osmocom/osmo-e1-hardware/hardware/e1-xcvr/e1_xcvr.brd

## EAGLE design hardware/e1-xcvr/e1_xcvr.brd (2020-11-04)

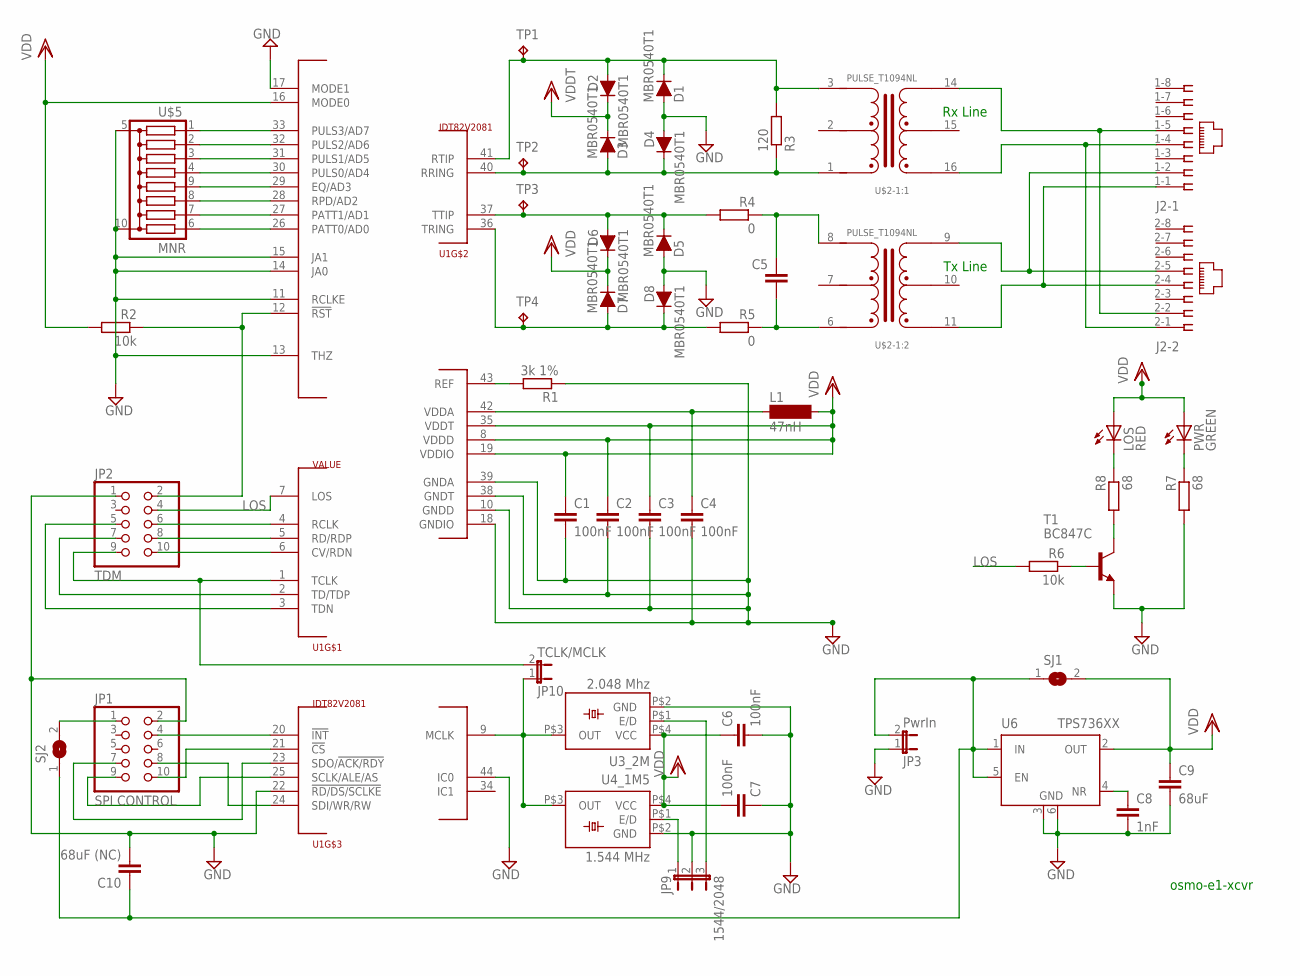
[picture p4: schematic e1_xcvr.sch]

Parts:
C1, C2, C3, C4, C6, C7: 100nF; C0603
C5: C-EUC0603; C0603
C8: 1nF; C0603
C9: 68uF; C1206K
C10: 68uF (NC); C1206K
D1, D2, D3, D4, D5, D6, D7, D8: MBR0540T1; SOD123
J2: 557560-1
JP1: SPI CONTROL; 2X05
JP2: TDM; 2X05
JP3: PwrIn; JP1
JP9: 1544/2048; JP2
JP10: TCLK/MCLK; JP1
L1: 47nH; SM-1206
LOS: RED; CHIPLED_0805
PWR: GREEN; CHIPLED_0805
R1: 3k 1%; R0603
R2, R6: 10k; R0603
R3: 120; R0603
R4, R5: 0; R0603
R7, R8: 68; R0603
SJ1, SJ2: SJ
T1: BC847C; SOT23-BEC
TP1, TP2, TP3, TP4: TPPAD1-13; P1-13
U1: IDT82V2081; TQFP44
U3_2M: 2.048 Mhz; HC73
U4_1M5: 1.544 MHz; HC73
U6: TPS736XX; SOT223-6
U$2: PULSE_T1094NL; PULSE_BH
U$5: MNR; MNR35

Connections:
!CS: JP1.10, U1.21 (!CS)
!INT: JP1.4, U1.20 (!INT)
!RST: JP2.2, R2.1, U1.12 (!RST)
GND: C1.2, C2.2, C3.2, C4.2, C6.2, C7.1, C8.2, C9.2, C10.2, D1.2 (A), D4.2 (A), D5.2 (A), D8.2 (A), JP1.2, JP2.1, JP3.1, JP9.2, R1.1, R7.2, T1.E, U1.10 (GNDD), U1.11 (RCLKE), U1.13 (THZ), U1.14 (JA0), U1.15 (JA1), U1.17 (MODE1), U1.18 (GNDIO), U1.22 (!RD/DS/SCLKE), U1.38 (GNDT), U1.39 (GNDA), U1.44 (IC0), U3_2M.P$2 (GND), U4_1M5.P$2 (GND), U6.3 (GND), U6.6 (GND1), U$5.5 (C), U$5.10 (D)
LOS: JP2.4, R6.2, U1.7 (LOS)
MCLK: JP10.1, U1.9 (MCLK), U3_2M.P$3 (OUT), U4_1M5.P$3 (OUT)
unnamed: R1.2, U1.43 (REF)
unnamed: LOS.C, R8.1
unnamed: U1.33 (PULS3/AD7), U$5.1
unnamed: U1.32 (PULS2/AD6), U$5.2
unnamed: U1.31 (PULS1/AD5), U$5.3
unnamed: U1.30 (PULS0/AD4), U$5.4
unnamed: U1.29 (EQ/AD3), U$5.9 (5)
unnamed: U1.28 (RPD/AD2), U$5.8 (6)
unnamed: U1.27 (PATT1/AD1), U$5.7
unnamed: U1.26 (PATT0/AD0), U$5.6 (8)
unnamed: R8.2, T1.C
unnamed: C4.1, L1.1, U1.42 (VDDA)
unnamed: R6.1, T1.B
unnamed: C5.1, R4.1, U$2.8
unnamed: PWR.C, R7.1
unnamed: C5.2, R5.1, U$2.6
unnamed: J2.1-2 (2), J2.2-5 (5), U$2.9
unnamed: J2.1-4 (4), J2.2-1 (1), U$2.16
unnamed: JP9.3, U3_2M.P$1 (E/D)
unnamed: J2.1-1 (1), J2.2-4 (4), U$2.11
unnamed: C8.1, U6.4 (NR)
unnamed: JP9.1, U4_1M5.P$1 (E/D)
unnamed: J2.1-5 (5), J2.2-2 (2), U$2.14
RCLK: JP2.6, U1.4 (RCLK)
RDN: JP2.10, U1.6 (CV/RDN)
RDP: JP2.8, U1.5 (RD/RDP)
RRING: D3.2 (A), D4.1 (C), R3.1, TP2.TP, U1.40 (RRING), U$2.1
RTIP: D1.1 (C), D2.2 (A), R3.2, TP1.TP, U1.41 (RTIP), U$2.3
SCLK: JP1.9, U1.25 (SCLK/ALE/AS)
SDI: JP1.8, U1.24 (SDI/WR/RW)
SDO: JP1.7, U1.23 (SDO/!ACK/RDY)
TCLK: JP2.9, JP10.2, U1.1 (TCLK)
TDN: JP2.5, U1.3 (TDN)
TDP: JP2.7, U1.2 (TD/TDP)
TRING: D7.2 (A), D8.1 (C), R5.2, TP4.TP, U1.36 (TRING)
TTIP: D5.1 (C), D6.2 (A), R4.2, TP3.TP, U1.37 (TTIP)
VDD: C1.1, C2.1, C3.1, C6.1, C7.2, C9.1, D2.1 (C), D3.1 (C), D6.1 (C), D7.1 (C), L1.2, LOS.A, PWR.A, R2.2, SJ1.2, U1.8 (VDDD), U1.16 (MODE0), U1.19 (VDDIO), U1.35 (VDDT), U3_2M.P$4 (VCC), U4_1M5.P$4 (VCC), U6.2 (OUT)
VIN: C10.1, JP3.2, SJ1.1, SJ2.1, U6.1 (IN), U6.5 (EN)
_VIN: JP1.1, SJ2.2

Notes on the sheet:
Rx Line
Tx Line
osmo-e1-xcvr

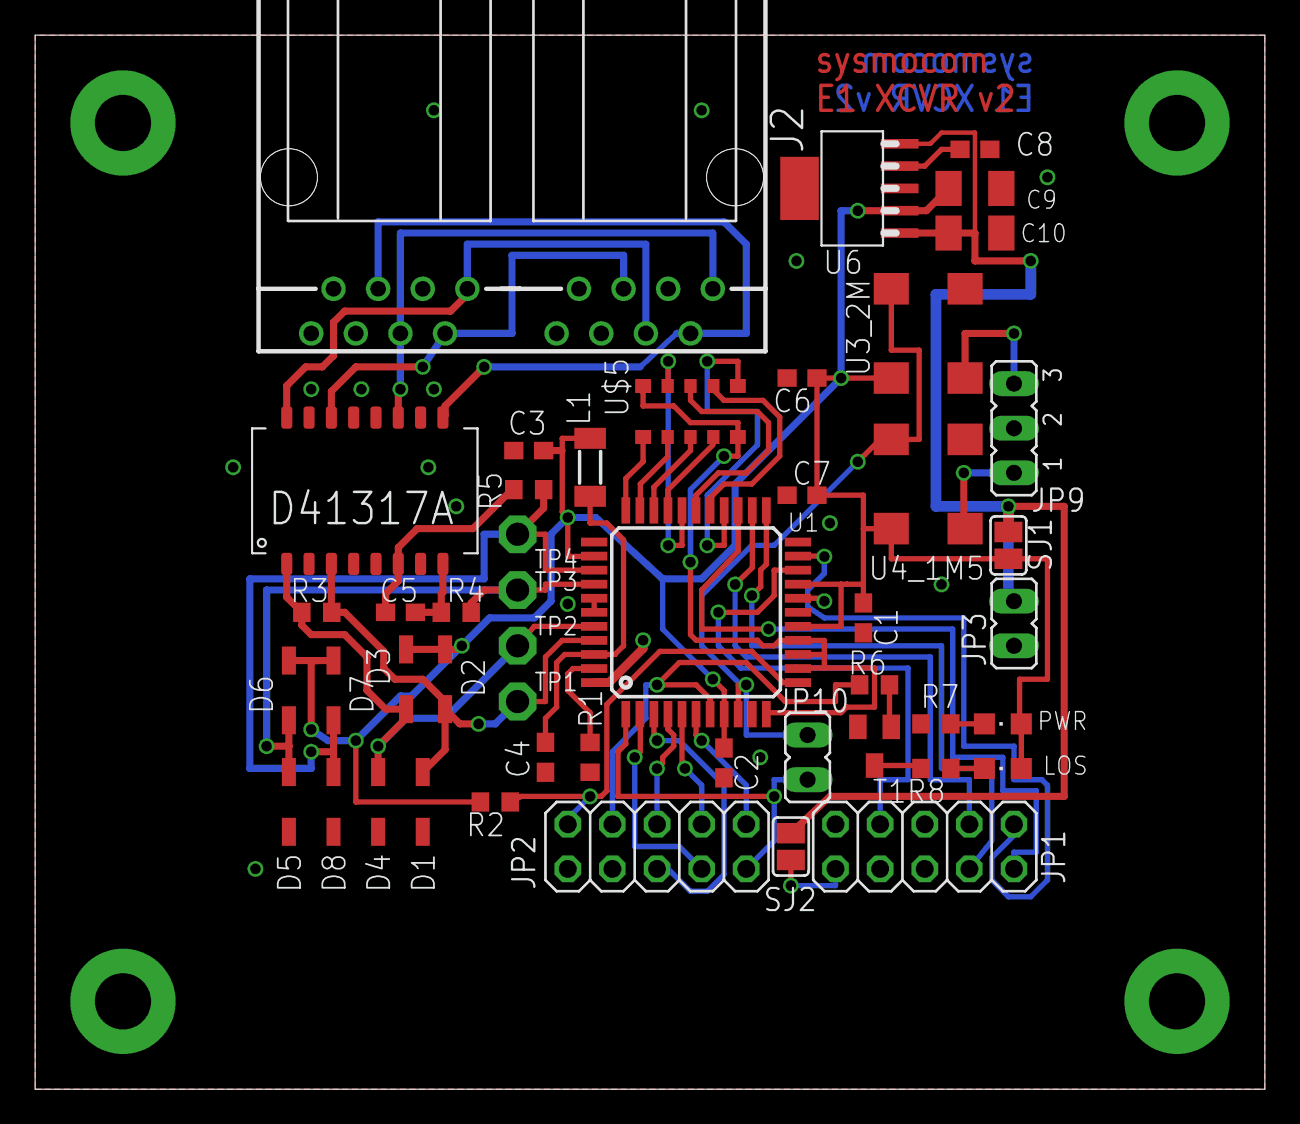
[picture p5: board e1_xcvr.brd from above]

Board: 2 copper layers, 70.0 x 60.0 mm, 48 parts (0 on the bottom side), 45 nets.
