osmocom/osmo-e1-hardware/hardware/icE1usb-proto/icE1usb-proto.brd

## EAGLE design hardware/icE1usb-proto/icE1usb-proto.brd (2020-09-14)

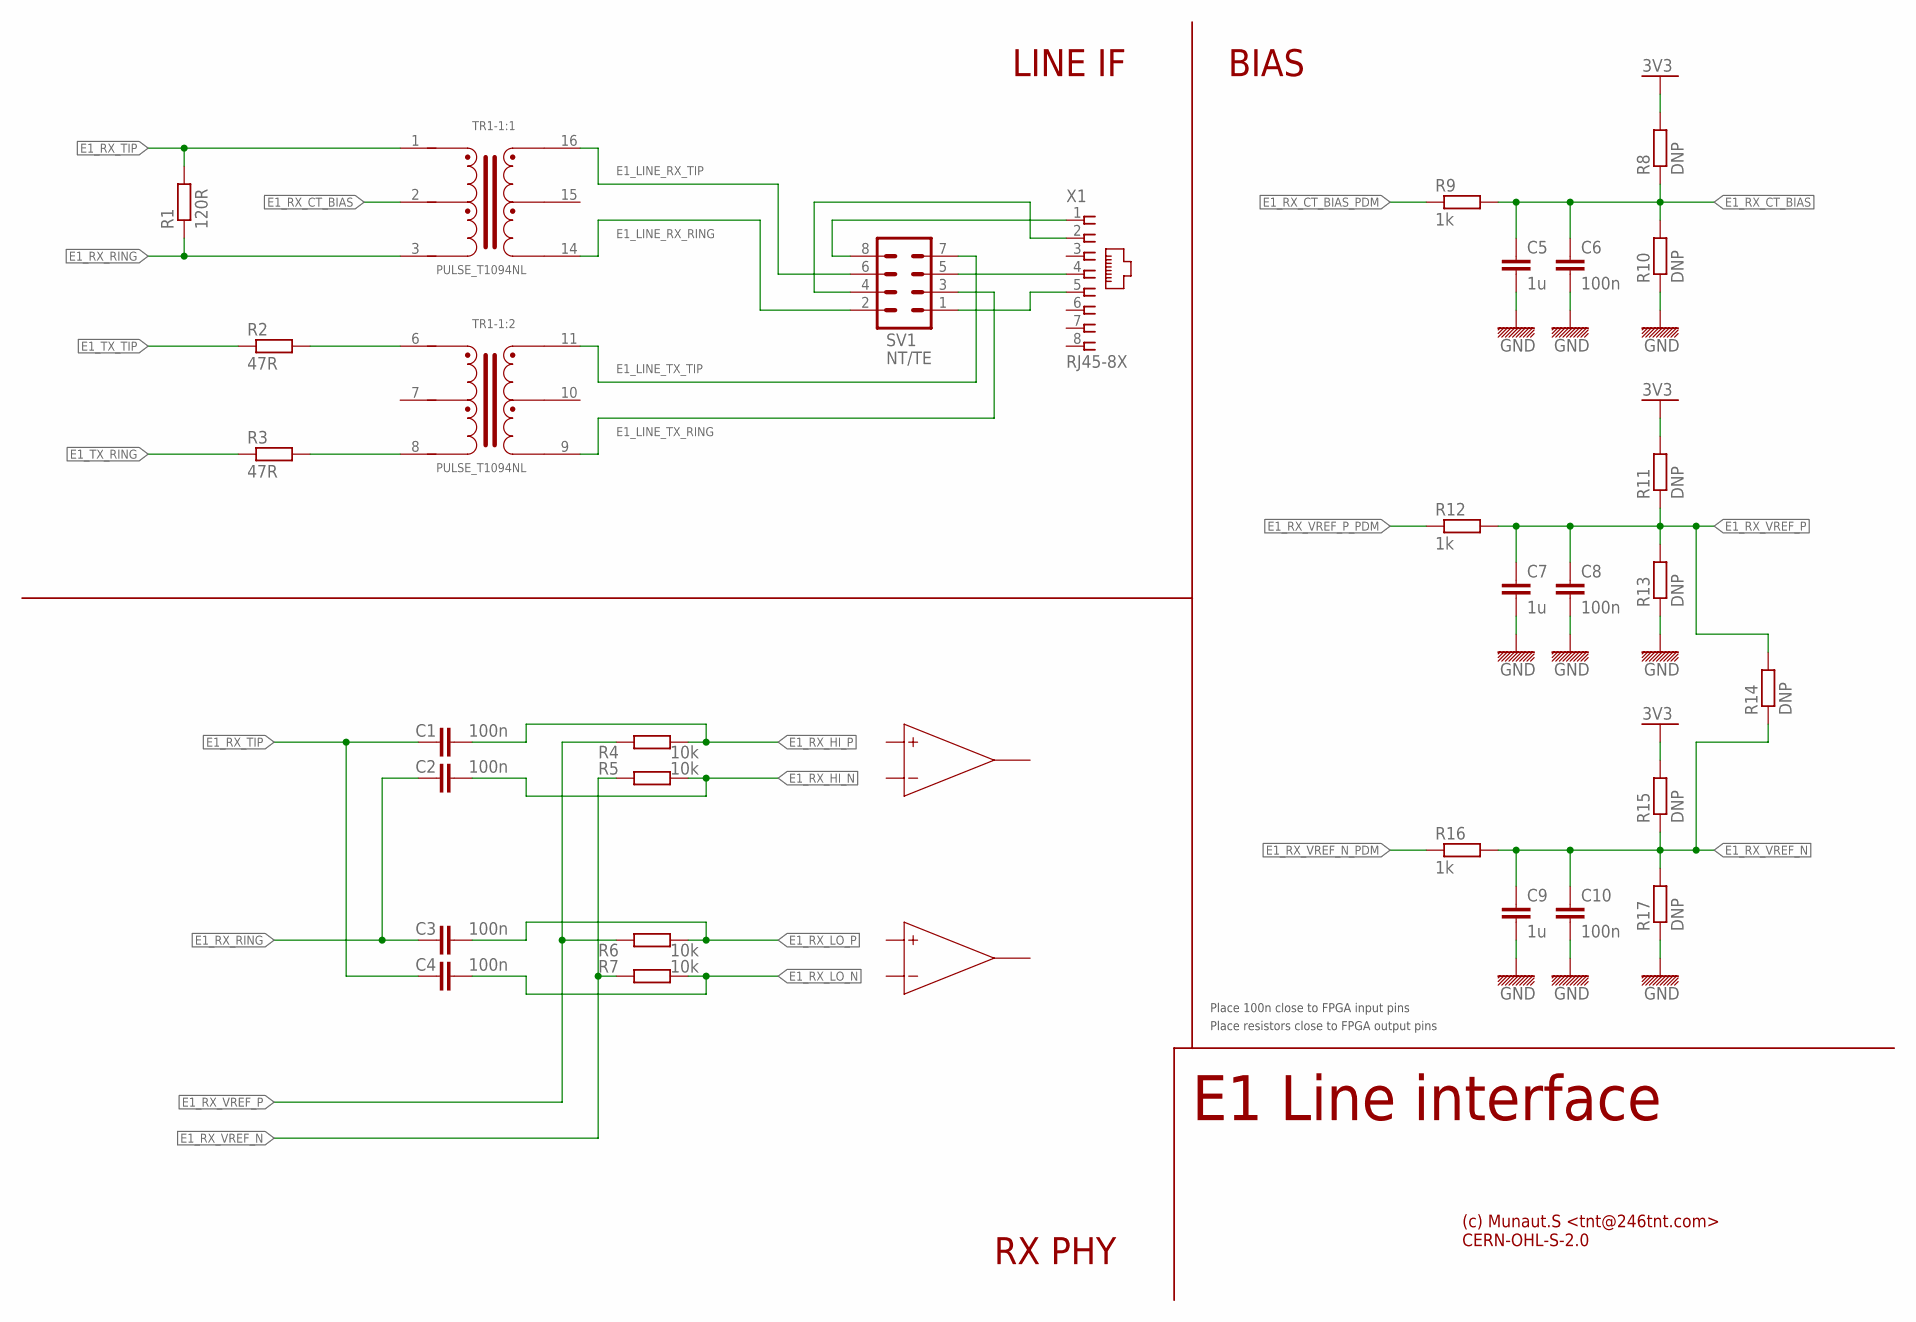
[picture p6: schematic icE1usb-proto.sch, sheet 1, <b>E1 Line interface</b>]

Parts:
C1, C2, C3, C4, C6, C8, C10: 100n; 0603
C5, C7, C9: 1u; 0603
R1: 120R; 0603_A
R2, R3: 47R; 0603_A
R4, R5, R6, R7: 10k; 0603_A
R8, R10, R11, R13, R14, R15, R17: DNP; 0603_A
R9, R12, R16: 1k; 0603_A
SV1: NT/TE; MA04-2
TR1: PULSE_T1094NL; PULSE_BH
X1: RJ45-8X; RJ45-NO-SHIELD

Connections:
3V3: R8.2, R11.2, R15.2; also elsewhere on the board
E1_LINE_P1: SV1.8, X1.1
E1_LINE_P2: SV1.4, X1.2
E1_LINE_P4: SV1.5, X1.4
E1_LINE_P5: SV1.1, X1.5
E1_LINE_RX_RING: SV1.2, TR1.14
E1_LINE_RX_TIP: SV1.6, TR1.16
E1_LINE_TX_RING: SV1.3, TR1.9
E1_LINE_TX_TIP: SV1.7, TR1.11
E1_RX_CT_BIAS: C5.1, C6.1, R8.1, R9.2, R10.2, TR1.2
E1_RX_CT_BIAS_PDM: R9.1; also elsewhere on the board
E1_RX_HI_N: C2.2, R5.2; also elsewhere on the board
E1_RX_HI_P: C1.2, R4.2; also elsewhere on the board
E1_RX_LO_N: C4.2, R7.2; also elsewhere on the board
E1_RX_LO_P: C3.2, R6.2; also elsewhere on the board
E1_RX_RING: C2.1, C3.1, R1.1, TR1.3
E1_RX_TIP: C1.1, C4.1, R1.2, TR1.1
E1_RX_VREF_N: C9.1, C10.1, R5.1, R7.1, R14.1, R15.1, R16.2, R17.2
E1_RX_VREF_N_PDM: R16.1; also elsewhere on the board
E1_RX_VREF_P: C7.1, C8.1, R4.1, R6.1, R11.1, R12.2, R13.2, R14.2
E1_RX_VREF_P_PDM: R12.1; also elsewhere on the board
E1_TX_RING: R3.1; also elsewhere on the board
E1_TX_TIP: R2.1; also elsewhere on the board
GND: C5.2, C6.2, C7.2, C8.2, C9.2, C10.2, R10.1, R13.1, R17.1; also elsewhere on the board
unnamed: R2.2, TR1.6
unnamed: R3.2, TR1.8

Notes on the sheet:
BIAS
LINE IF
RX PHY
E1 Line interface
Place 100n close to FPGA input pins
Place resistors close to FPGA output pins
(c) Munaut.S <tnt@246tnt.com> CERN-OHL-S-2.0
