osmocom/osmo-e1-hardware/hardware/icE1usb-proto/icE1usb-proto.brd

## EAGLE design hardware/icE1usb-proto/icE1usb-proto.brd (continued)

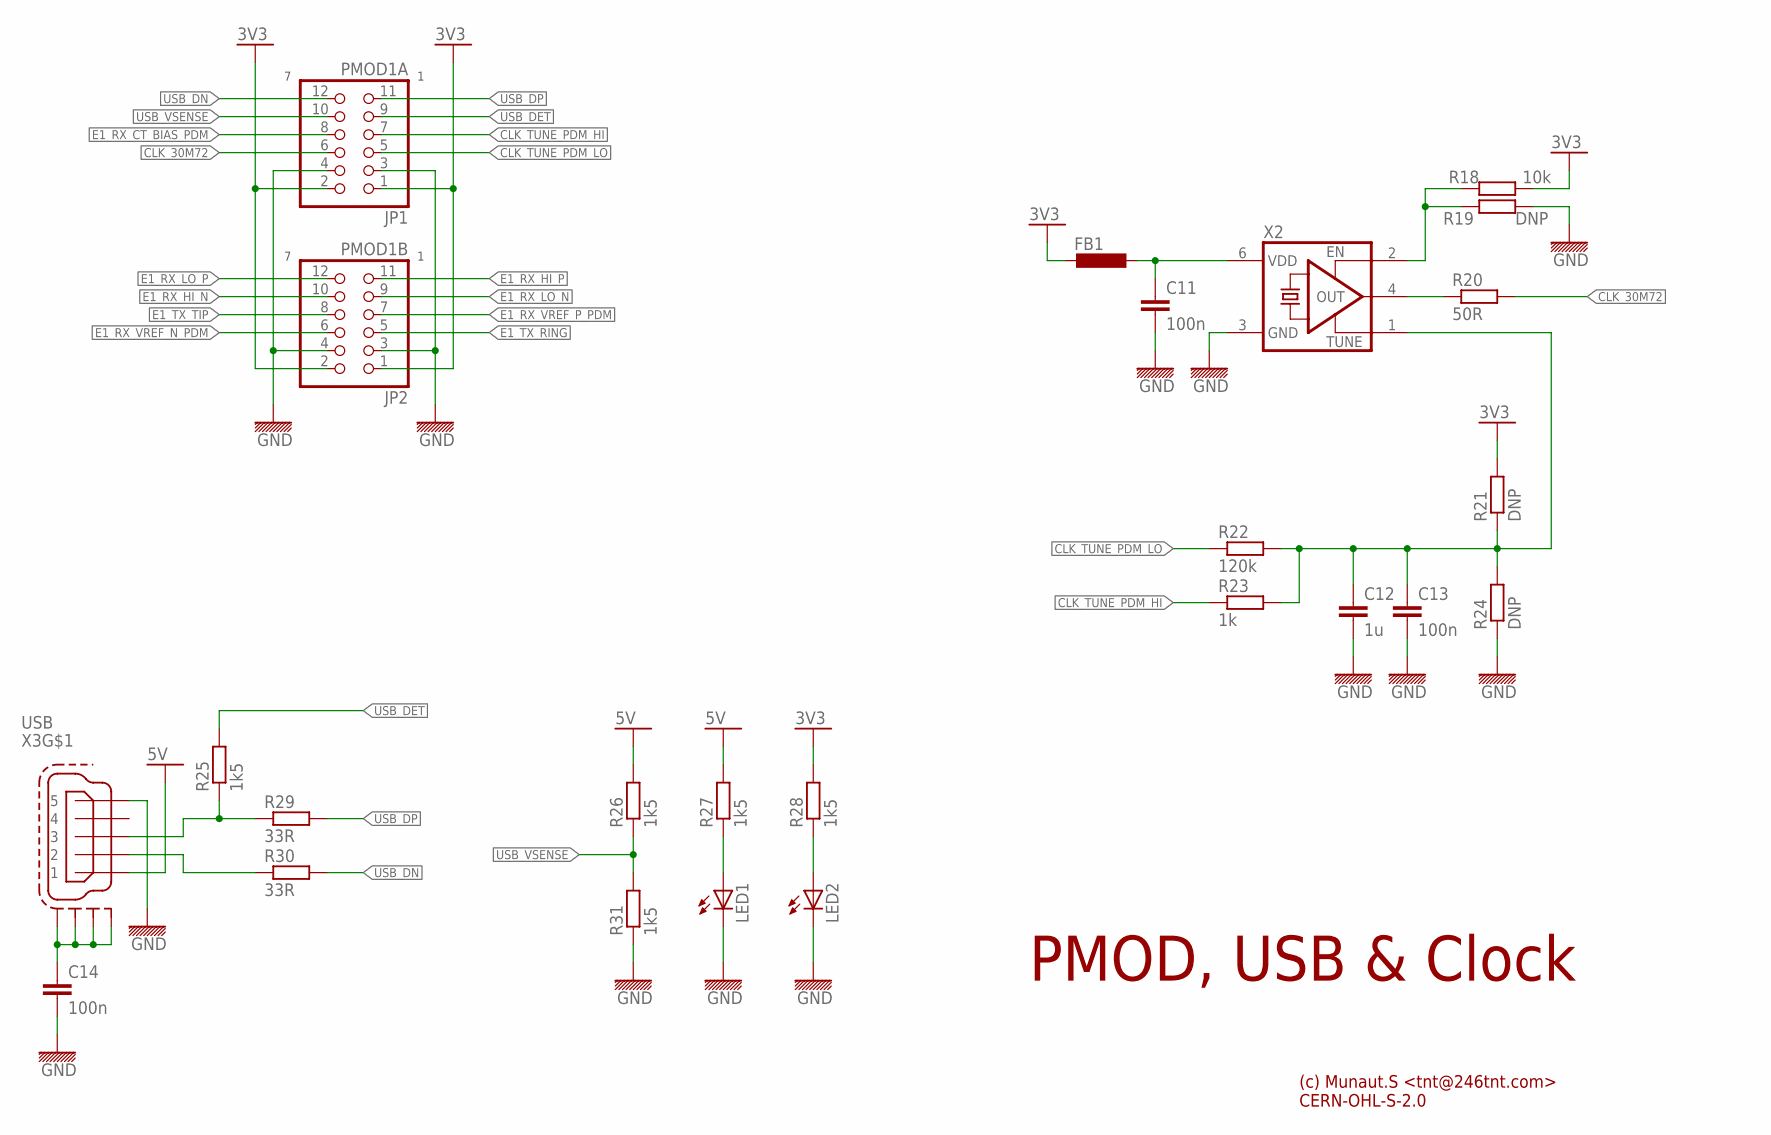
[picture p7: schematic icE1usb-proto.sch, sheet 2, <b>PMOD, USB & Clock</b>]

Parts:
C11, C13, C14: 100n; 0603
C12: 1u; 0603
FB1: FBEAD_0603; 0603
JP1: PMOD1A; 2X06/90
JP2: PMOD1B; 2X06/90
LED1, LED2: LEDCHIPLED_0603; CHIPLED_0603
R18: 10k; 0603_A
R19, R21, R24: DNP; 0603_A
R20: 50R; 0603_A
R22: 120k; 0603_A
R23: 1k; 0603_A
R25, R26, R27, R28, R31: 1k5; 0603_A
R29, R30: 33R; 0603_A
X2: XTAL_OSC_ET_CFPV-45/46; CFPV-45/46
X3: USB; 32005-201

Connections:
3V3: FB1.1, JP1.1, JP1.2, JP2.1, JP2.2, R18.2, R21.2, R28.2; also elsewhere on the board
5V: R26.2, R27.2, X3.1
CLK_30M72: JP1.6, R20.2
CLK_30M72_RAW: R20.1, X2.4 (OUT)
CLK_TUNE: C12.1, C13.1, R21.1, R22.2, R23.2, R24.2, X2.1 (TUNE)
CLK_TUNE_PDM_HI: JP1.7, R23.1
CLK_TUNE_PDM_LO: JP1.5, R22.1
E1_RX_CT_BIAS_PDM: JP1.8; also elsewhere on the board
E1_RX_HI_N: JP2.10; also elsewhere on the board
E1_RX_HI_P: JP2.11; also elsewhere on the board
E1_RX_LO_N: JP2.9; also elsewhere on the board
E1_RX_LO_P: JP2.12; also elsewhere on the board
E1_RX_VREF_N_PDM: JP2.6; also elsewhere on the board
E1_RX_VREF_P_PDM: JP2.7; also elsewhere on the board
E1_TX_RING: JP2.5; also elsewhere on the board
E1_TX_TIP: JP2.8; also elsewhere on the board
GND: C11.2, C12.2, C13.2, C14.2, JP1.3, JP1.4, JP2.3, JP2.4, LED1.C, LED2.C, R19.2, R24.1, R31.1, X2.3 (GND), X3.5; also elsewhere on the board
unnamed: C11.1, FB1.2, X2.6 (VDD)
unnamed: R18.1, R19.1, X2.2 (EN)
unnamed: C14.1, X3.M1 (S1), X3.M2 (S2), X3.M3 (S3), X3.M4 (S4)
unnamed: LED1.A, R27.1
unnamed: LED2.A, R28.1
USB_DET: JP1.9, R25.2
USB_DN: JP1.12, R30.2
USB_DN_PIN: R30.1, X3.2
USB_DP: JP1.11, R29.2
USB_DP_PIN: R25.1, R29.1, X3.3
USB_VSENSE: JP1.10, R26.1, R31.2

Notes on the sheet:
PMOD, USB & Clock
(c) Munaut.S <tnt@246tnt.com> CERN-OHL-S-2.0

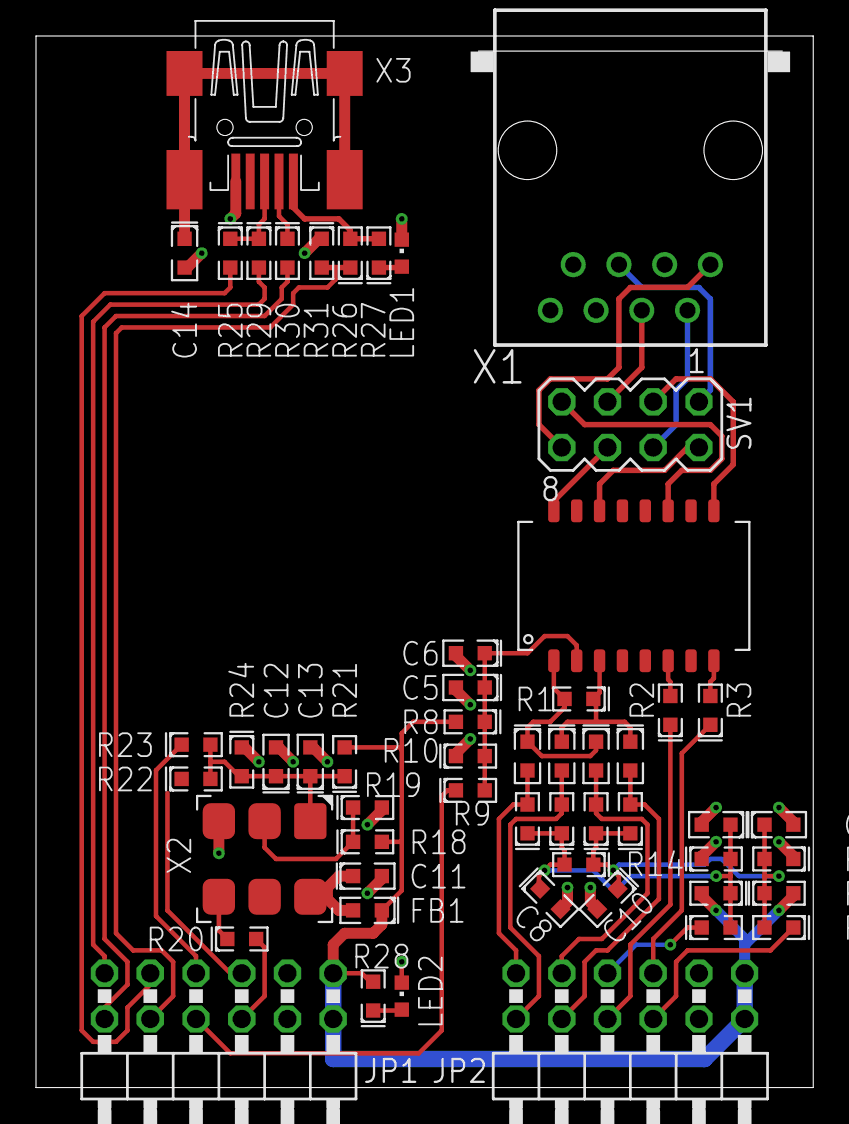
[picture p8: board icE1usb-proto.brd from above]

Board: 2 copper layers, 43.2 x 58.4 mm, 55 parts (0 on the bottom side), 43 nets.
