osmocom/osmo-e1-hardware/hardware/e1-tap/e1_tap.brd

## EAGLE design hardware/e1-tap/e1_tap.brd (2012-07-21)

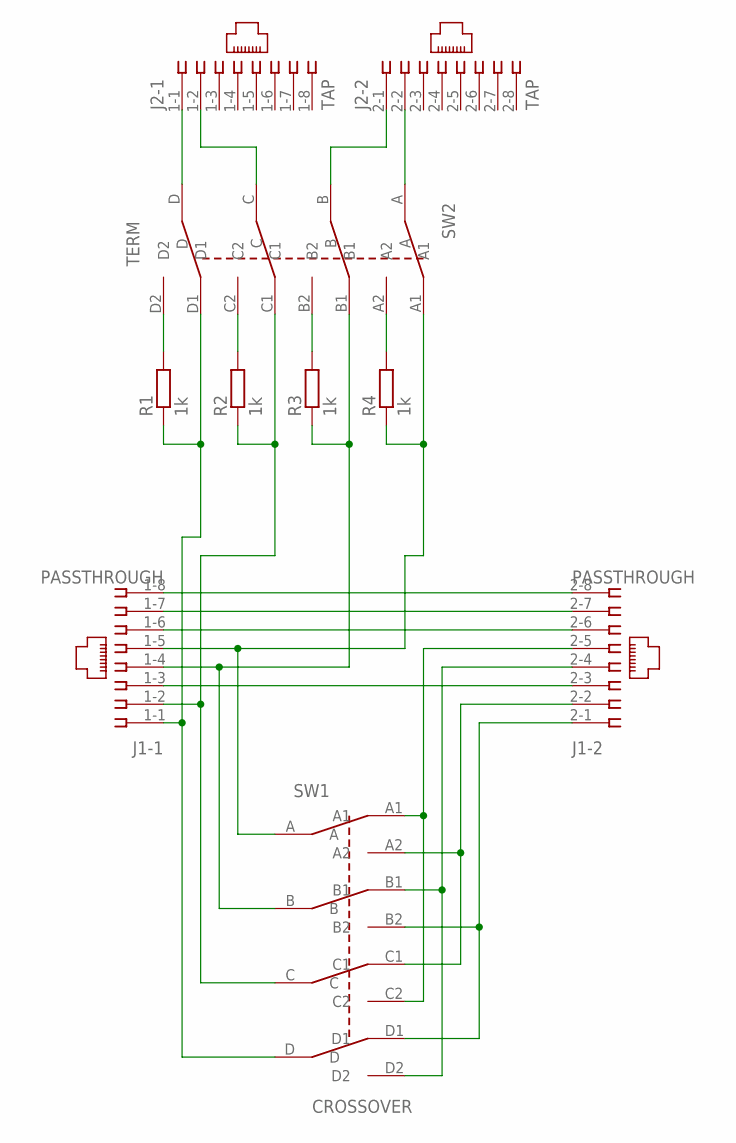
[picture p9: schematic e1_tap.sch]

Parts:
J1: PASSTHROUGH; 557560-1
J2: TAP; 557560-1
R1, R2, R3, R4: 1k; R0603
SW1: CROSSOVER; 4PDT_DIL12
SW2: TERM; 4PDT_DIL12

Connections:
CROSS: J1.2-4 (4), SW1.B1, SW1.D2
unnamed: J1.1-8 (8), J1.2-8 (8)
unnamed: J1.1-7 (7), J1.2-7 (7)
unnamed: J1.1-6 (6), J1.2-6 (6)
unnamed: J1.1-3 (3), J1.2-3 (3)
unnamed: J1.1-2 (2), R2.1, SW1.C, SW2.C1
unnamed: J1.1-1 (1), R1.1, SW1.D, SW2.D1
unnamed: J1.1-4 (4), R3.1, SW1.B, SW2.B1
unnamed: J1.1-5 (5), R4.1, SW1.A, SW2.A1
unnamed: J1.2-5 (5), SW1.A1, SW1.C2
unnamed: J2.1-1 (1), SW2.D
unnamed: J1.2-2 (2), SW1.A2, SW1.C1
unnamed: J1.2-1 (1), SW1.B2, SW1.D1
unnamed: J2.1-2 (2), SW2.C
unnamed: J2.2-1 (1), SW2.B
unnamed: J2.2-2 (2), SW2.A
unnamed: R1.2, SW2.D2
unnamed: R2.2, SW2.C2
unnamed: R3.2, SW2.B2
unnamed: R4.2, SW2.A2

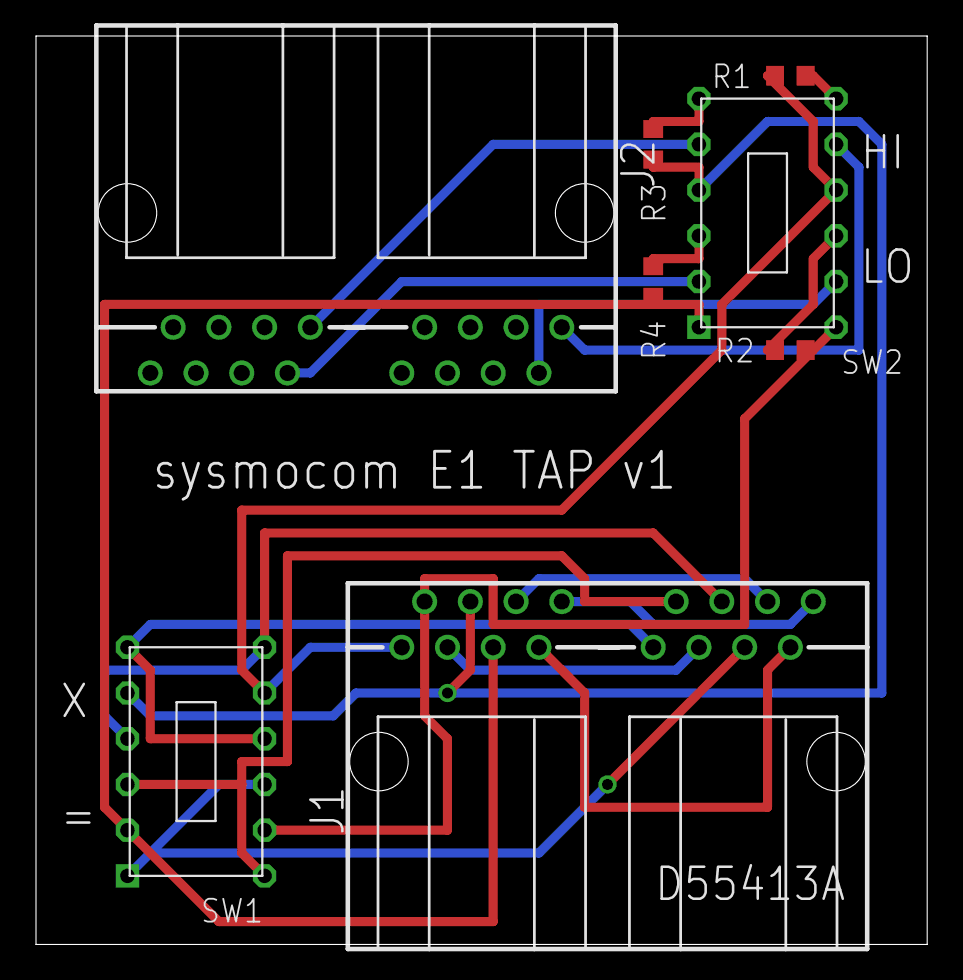
[picture p10: board e1_tap.brd from above]

Board: 2 copper layers, 49.5 x 50.5 mm, 8 parts (0 on the bottom side), 20 nets.
