osmocom/osmo-e1-hardware/(notices)

Notices in the files:
hardware/e1-tracer/e1-tracer.brd:
OSHW / CC-BY-SA 4.0
parts and their libraries:
Wuerth_Elektronik_eiSos_V6_20140807: Copyright: Würth Elektronik
microbuilder: This work is placed in the public domain, and may be freely used for commercial and non-commercial work with the following conditions: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
